uliknopf/Lora-node-gateway/Gateway/SchaltplanGateway.png

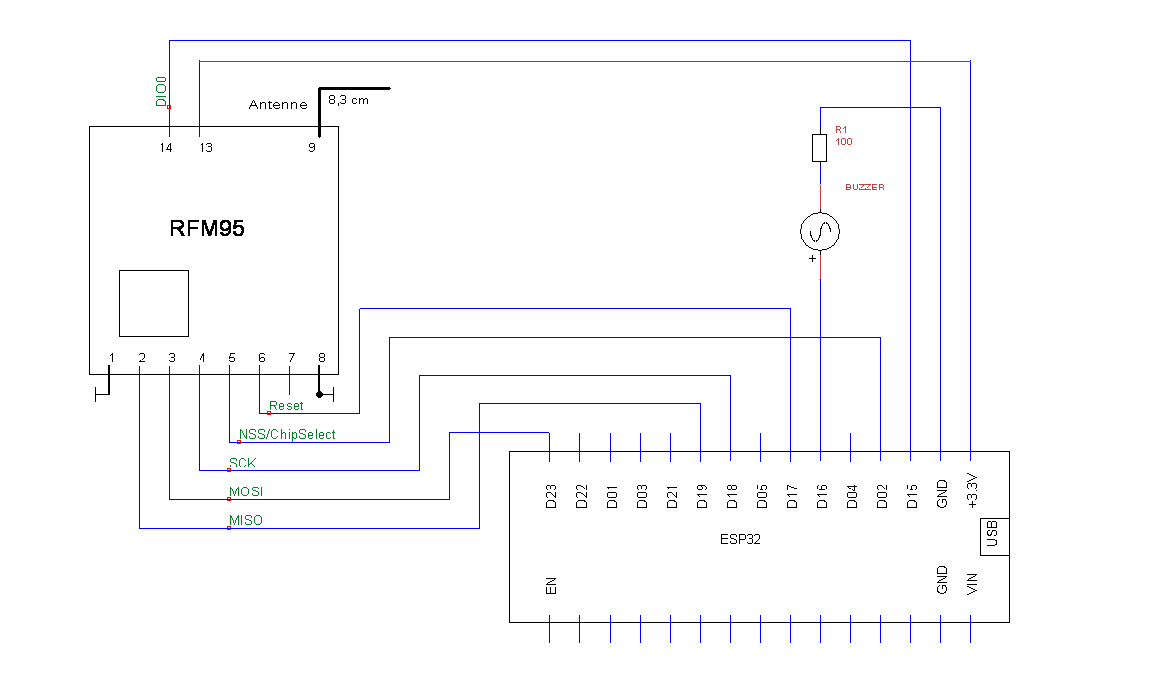
Gateway/SchaltplanGateway.png
