uliknopf/Lora-node-gateway/Node/SchaltplanNode.png

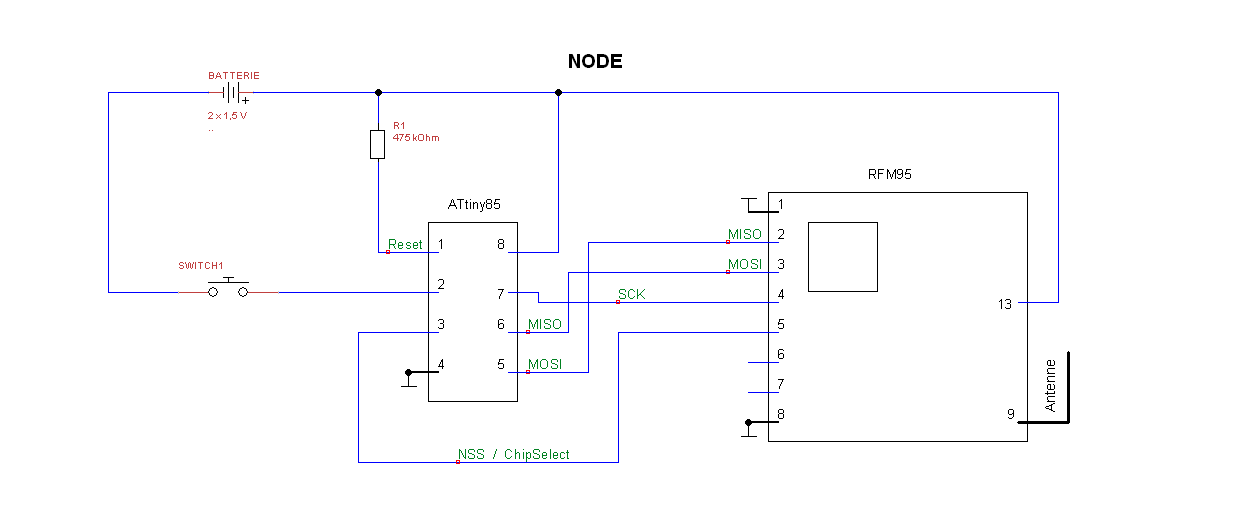
Node/SchaltplanNode.png
